wulffern/rey_ldo_sky130a/(commit log)

2026-08-16 Made REY_LDO_SKY130A
    [REY_LDO.sch]
2026-08-16 feat: REY_LDO layout -- sidecar, DRC/KDRC/LVS/ANT clean
    One declarative sidecar (REY_LDO.py) builds the whole cell: seven
    subcells (two ladder halves, tail resistor, nmos pair, pmos mirror,
    pass device, two MiM banks) and the assembled top, 73 x 68 um.
    - resistor columns mirrored MX so the series chain ascends in
    netlist order with every link a short M1 vertical in one lane
    - ladder split at REF_1V2 (28.8 + 16.8 um) instead of one 40.8 um
    column towering over a 17 um row
    - r_div2's VDD pin lifted to a narrow M2 pad at the column top so
    the ring strap never crosses the guard or the link lane
    - MiM banks placed as grids and wired as plate combs, no vias
    - crossing nets as mid-channel Ch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
    [REY_LDO.sch, REY_LDO_C_COMP.sch, REY_LDO_C_REF.sch, REY_LDO_N_DIFF.sch, REY_LDO_P_LOAD.sch, REY_LDO_P_OUT.sch, REY_LDO_R_DIV1.sch, REY_LDO_R_DIV2.sch]
2026-08-16 feat: cicsim testbenches for REY_LDO -- lstb, load/line step, PSRR
    sim/REY_LDO, modeled on LELOTEMP_BIAS_IBP's lstb and LELO_EX's flow:
    - lstb: Tian probe between VDD_1V2 and LPI, run at both load ends
    (Li: no load, Lh: 200 uA) as a cicsim corner dimension; a guarded
    gain-margin meas so corners whose phase never reaches 0 below
    1 GHz report -99 instead of failing the run
    - tran: load step 0 -> 200 uA -> 0 (100 ns edges) and a -100 mV
    line dip; droop, overshoot, load/line regulation, Iq
    - psrr: 1 V AC on VDD_1V8, 10 Hz to 100 MHz, both loads; specs set
    to the topology's own floor (divider reference -> -3.5 dB ideal)
    All 80 corner runs pass; the SPECS are red and honestly so: the
    l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
2026-08-16 docs: describe REY_LDO in the markdown sidecar
    The ratiometric reference and its PSRR floor, the resistor-set
    bias, quiescent budget, and the measured stability numbers with
    the compensation caveat.
